haniaa2/SmartMugs/Notebooks/haniaa2/README.md

# ECE445 **Hani Al Majed** Notebook

# Week 2/6  
- Researched the power subsystem of commercially available products (the Ember Mug primarily).   
- 02/09/2023: Finalized Project Proposal.

# Week 2/13  
- Explored possible Qi Reciever Modules, ended up with the Adafruit universal Qi wireless charging [transmitter](https://www.adafruit.com/product/2162) and [receiver](https://www.adafruit.com/product/1901) modules to perform inductive charging of two Samsung 25R 18650 2500mAh 20A [Battery cells](https://www.18650batterystore.com/products/samsung-25r-18650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). These modules can be configured to track battery level and output a discharge cut-off voltage of 5V. 
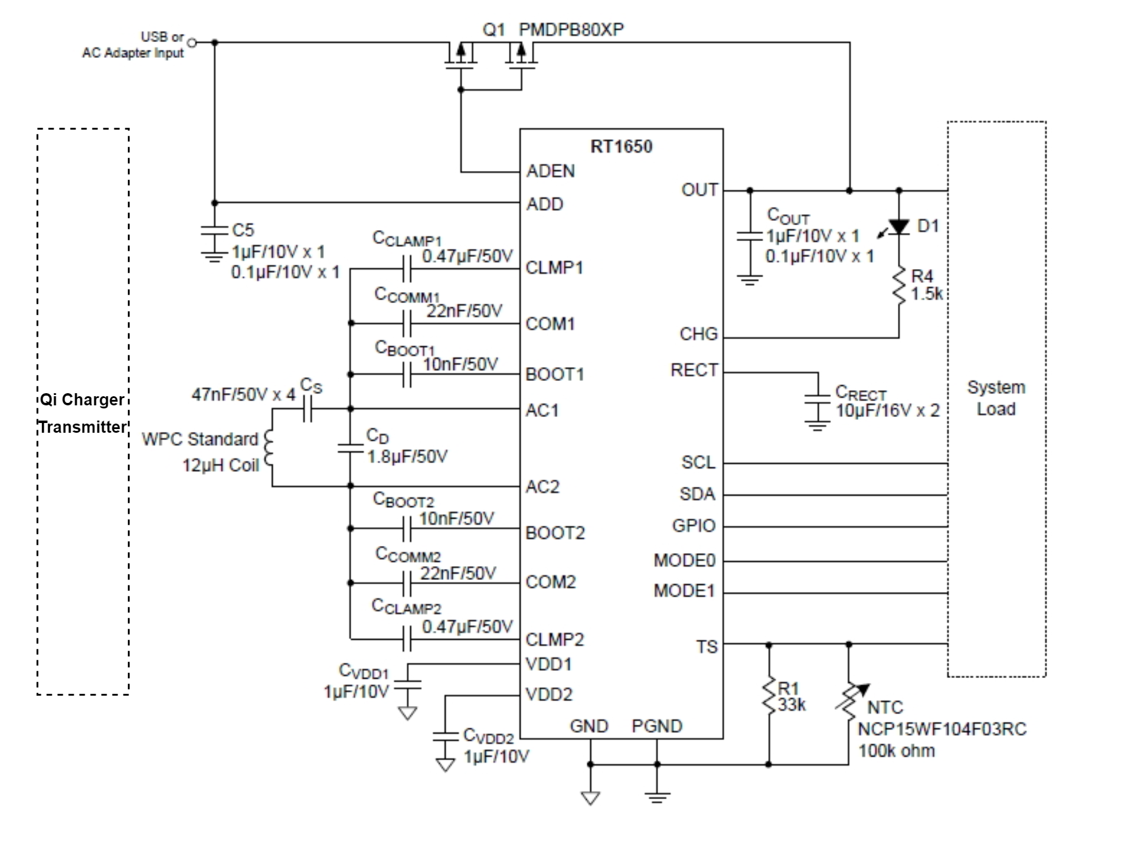
[picture p1: Notebooks/haniaa2/figures/RT1650-compliant-QiReciever-02-17-2023.png]
RT1650-compliant Qi Reciver


# Week 2/20  
- Finalized design document

# Week 2/27  
- 02/28/2023: Design Review with Prof. Mironenko was conducted.
- The block diagram was modified to take into account the comments of Prof. Mironenko 
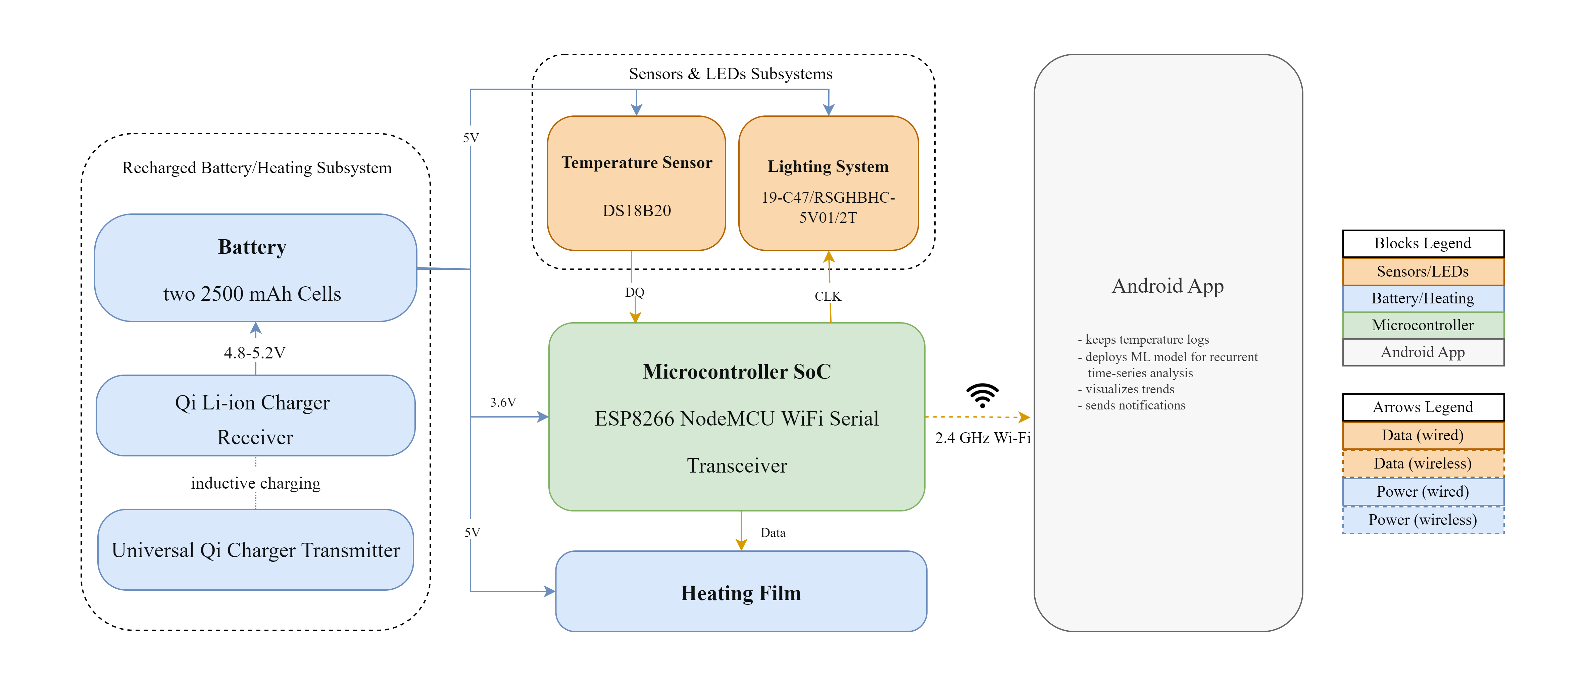
[picture p2: Notebooks/haniaa2/figures/block-diagram-03-02-2023.png]


# Week 3/6
- Actively developing the schematics of a NodeMCU Sheild to be connected to the PCB. Shelid footprint will be configured upon the successful completion of the PCB layout.   
- 03/08/2023: Selva & Jason proposed a single ESP32 SoC in lieu of the ESP8266 NodeMCU WiFi Serial Tranciever DevKit Board (rendering the previous design to be ineffective)
- 03/08/2023: Jason suggested the utilization of the TP4056-18650 Battery Management System as an intermediary layter between the Qi Reciever and the Li-ion Battey cells.  

# Week 3/20 
- Actively developing the schematics of the microcontroller subsystem with a [ESP32-WROVER-I](https://www.espressif.com/sites/default/files/documentation/esp32-wrover-e_esp32-wrover-ie_datasheet_en.pdf) MCU Module, [CP2102N-Axx-xQFN28](https://www.silabs.com/documents/public/data-sheets/cp2102n-datasheet.pdf) programmer, and mirco-usb port in a manner similar to the USB-to-UART serial conversion in the [ESSP32-C6 v4] (https://dl.espressif.com/dl/schematics/esp32_devkitc_v4-sch.pdf) Dvelopment kit. 
- The microcontroller expects 3.3-3.6V. To this end, I added the [AMS1117]([AMS1117](http://www.advanced-monolithic.com/pdf/ds1117.pdf)) LDO chip to regulate voltage to the desired voltage range.  
- Actively developing the power subsystem of our design to account for Jason's proposals. We have also added the TP4056-18650 battery management module to recharge the two battery cells and select the power supply output; the device is supplied with 5V form the USB bus if the USB port is connected. This addresses the contact bounce effects due to power spikes during external source power switching and reduces noise that causes battery exhaustion.
- The final power management subsystem will include a TP456-18650 Battey Mangement board connected to the Qi Reciever, the battery case, and an AMS1117 LDO voltage regulator.
- Siqi will handle the heating subsystem and would develop an automatic switching mechanism to adaptively control the temperature. 

# Week 3/27 
- The full device schametic is ready and a first PCB prototype is ready to be ordered.
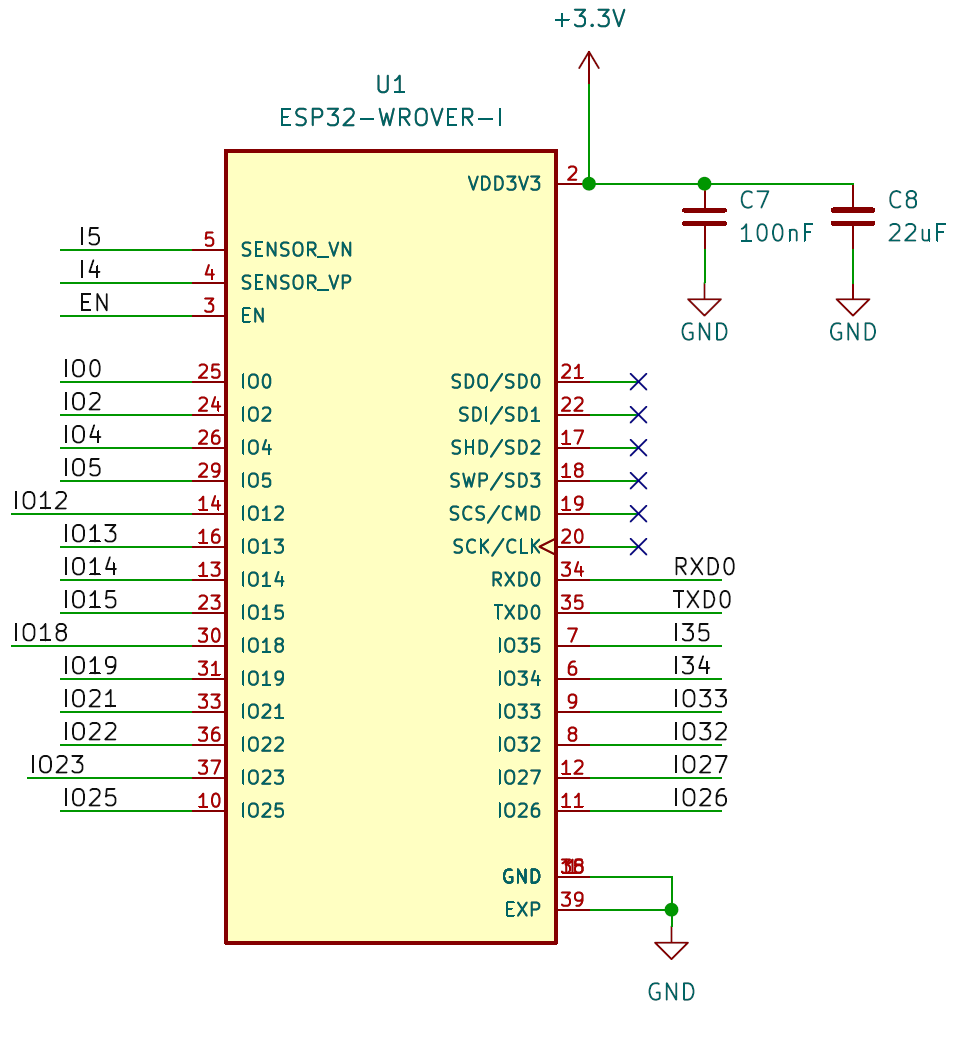
[picture p3: Notebooks/haniaa2/figures/mcu-module-03-25-2023.png]
MCU Module

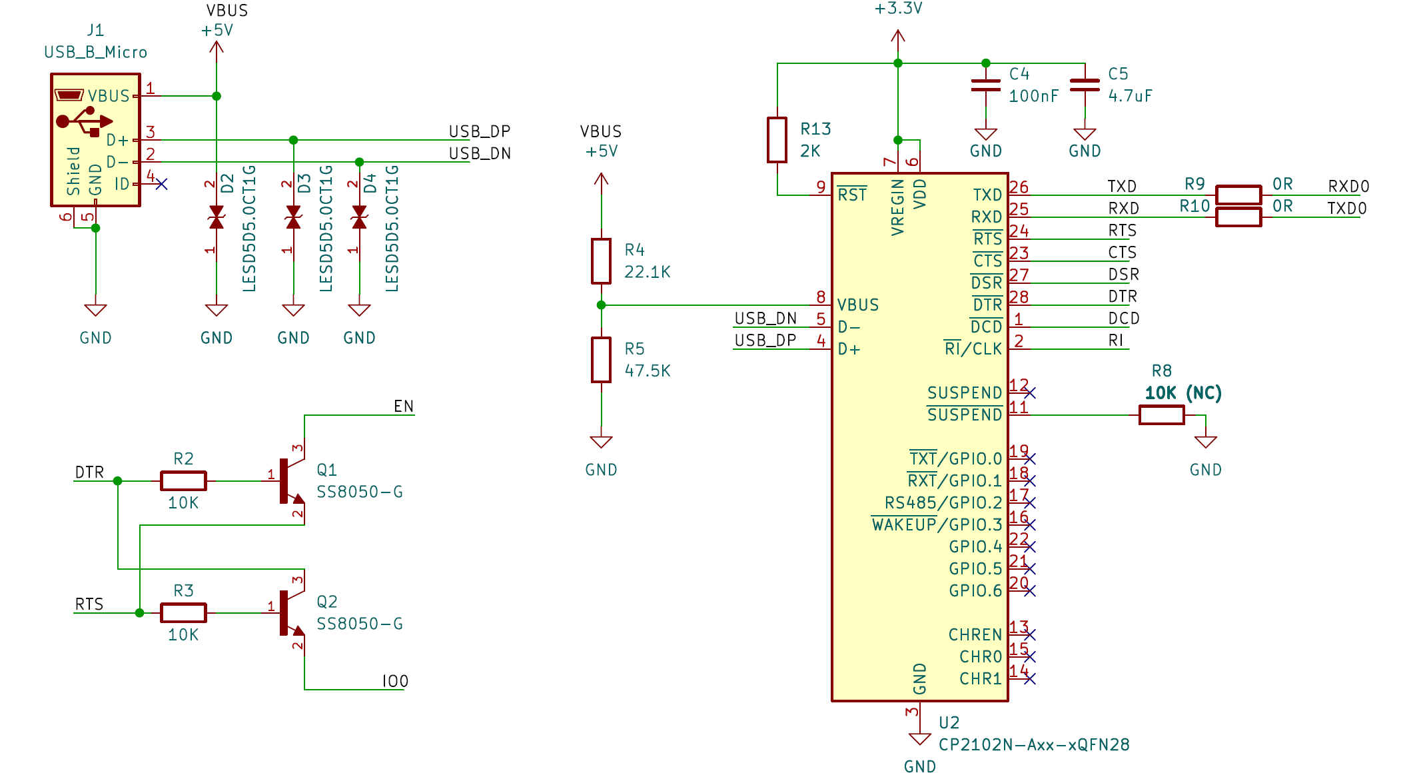
[picture p4: Notebooks/haniaa2/figures/mcu-programmer-03-25-2023.png]
MCU Programmer

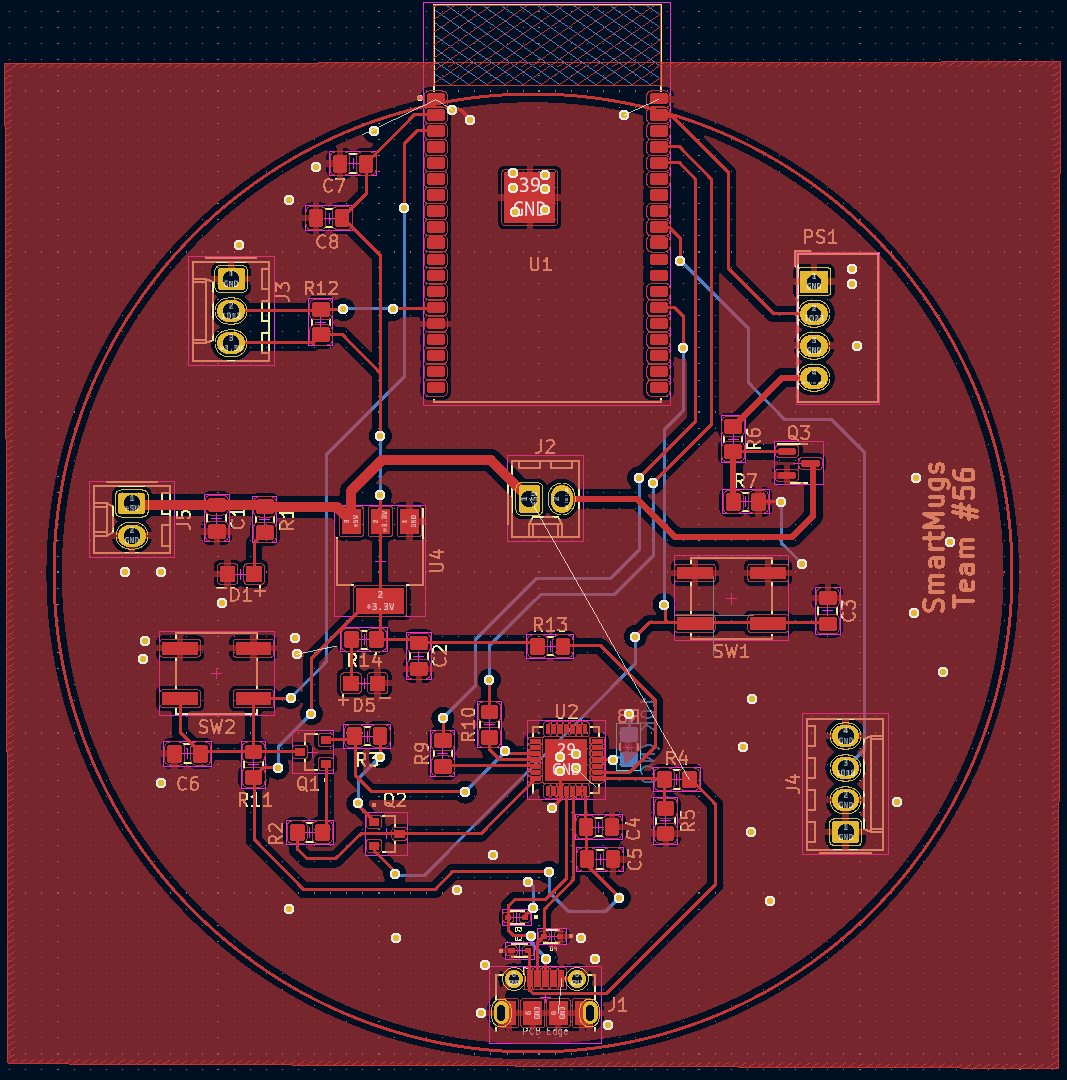
[picture p5: Notebooks/haniaa2/figures/pcb-v1-03-26-2023.png]
PCB Layout


# Week 4/3
- Siqi handled PCB soldering with me having supervisory role.  

# Week 4/10
- 04/19/2023: We had a meeting with Selva and chose to go with demoing on a breadboard instead since the PCB will take more time to solder and test. 

# Week 4/17
- 04/21/2023: Programmed the ESP32 DevKit to interface with my real-time database through a Google Firebase instance with a Wi-Fi client connection.
- 04/22/2023: The ESP32 was burnt due to connecting it with unprotected power circuitry.
- 04/23/2023: I got a spare ESP8266 in lieu of the ESP32 and decided to use that for our demo on Monday.
- I left Srishti with the MCU to integrate the Wi-Fi iterface with her frontend. 

# Week 4/24
- To balance out our work, I left Siqi and Srishti to do the full integration of the microcontroller unit with the circuit on the breadboard instead of having multiple MCUs. 
- Siqi will handle the heating element integration with a MOSFET that satisfies the specifications and requirements of our design. 

# Week 5/1
 - Collected further voltage traces of the Qi charger transmitter and the power management system to add them to the design verification section of the final report.
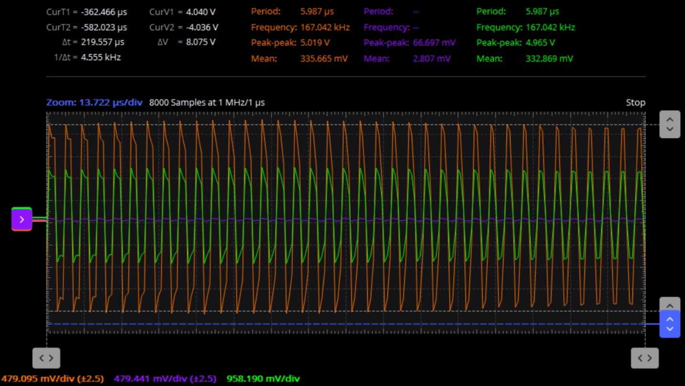
[picture p6: Notebooks/haniaa2/figures/qi_trans_vtrace-05-03-2023.jpg]

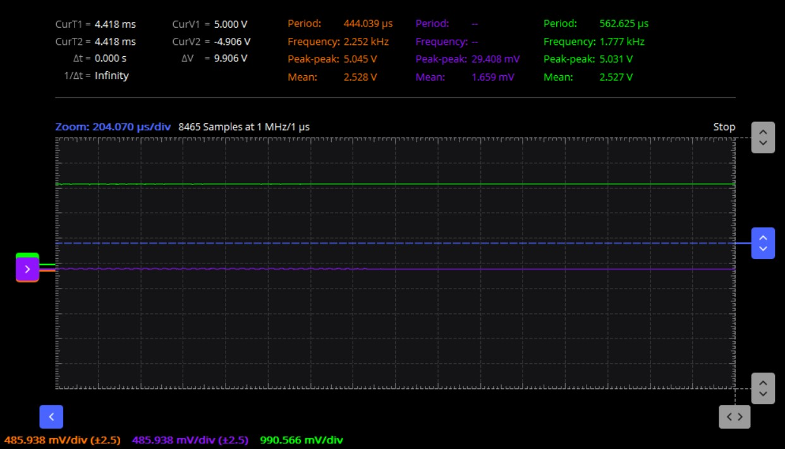
[picture p7: Notebooks/haniaa2/figures/power_management_vtrace-05-03-2023.jpg]


 - Working on the final report.
 - 05/01/2023: We had our final presentaion.
 - 05/03/2023: We had our final demo and submitted the final report!
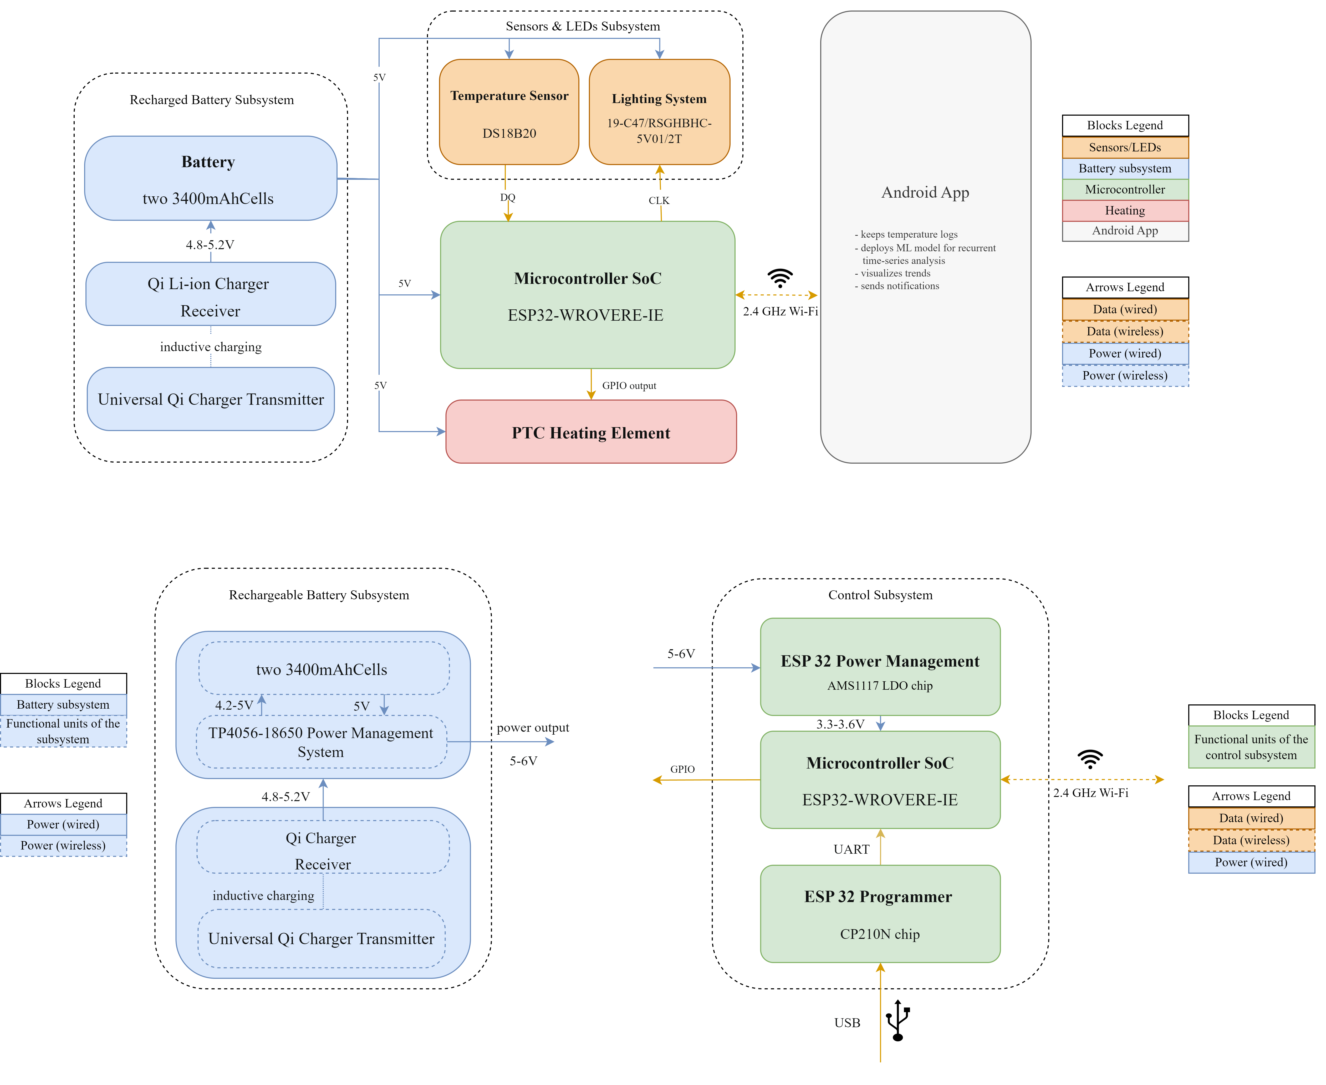
[picture p8: Notebooks/haniaa2/figures/final-block-diagram-05-03-2023.png]
Final Block Diagram
