haniaa2/SmartMugs/Notebooks/smogdil2/README.md

# ECE445 Srishti Modgil Notbook

# Week 02/06
- Project topics determined.
- Researching the design of smart mugs.
- Initial Project Proposal Finalized

# Week 02/13
-worked on design doc
- met with team members to discuss hwo to implement each subsystem
- research parts

# Week 02/20
-worked on design document 
- majority of research done this week 
- FInalaized a few part, such as heating element and microcontoller
- sumbitted finalazied design document 

# Week 03/06
- assigned roles to everyone 
- did some reaseach on how to build an app 
- deciced to build and IOS app 

# Week 03/13

- Created the app layout for the front page using uizard



# Week 03/20
- created the lay out for more of the pages of the app :





# Week 03/27
- finished the lay out for all the pages of the app :
 
 - submitted my individual progress report  

# Week 04/03
- created the ios app using swift

 
 
 - had meeting with my team and TA and decided to chnage the IOS app to a web app 

# Week 04/10

- created the whole front end of the web app :



# Week 04/17
- Building the circuit on the breadboard using the ESP32 Dev Board.
- 4/22: Demonstration the functionality of the circuit.  ESP32 Dev Board broke during our process of testing, we purchased the board immediately 
- 4/23: Connected the web app to ES8266. And connected ESP8266 to firebase real-time database 
- Test app with microcontoller, worked prefectly but not integreated with the heating system

# Week 04/24
- Mock presentation slides making and script writing.
- 4/29: Siqi and I met in the morning and finish most of the integration. Got the ESP32 and ingreated it with the web app and sensors and heating element 
- 4/30: Final prensentation preparation. Siqi and I took pictures and videos about what we go for the circuit so far. 
- FInished the slides for the presentation 

# Week 05/01
- 5/1: Final Presentation on May 1st, 8:30am. Presentation went very well
- 5/2: Whole breadboard circuit is completed  
- 5/3: Second Final Demo: Systems were integreated perfectly. Went very well.
