haniaa2/SmartMugs/Proposal.md

Team Members:
Srishti Modgil (smodgil2)
Siqi Lu (siqilu3)
Hani Al Majed (haniaa2)

# Problem

There is a problem with the inconvenience associated with maintaining the perfect temperature of beverages. Drinks can cool down quickly, making them no longer enjoyable. The need to reheat a drink can also be time consuming and inconvenient especially with a packed schedule. There is also a problem with waste. Disposable cups and reheating drinks can contribute to waste and negatively impact our environment. 
During our research, we found a smart mug called Embur Mug which can detect the temperature of the beverage and keeps it to a desired temperature. However, this mug is way too expensive for people to purchase with a price of 130 dollars. 

# Solution

We propose the creation of a smart mug. Our design will improve the Embur Mug functionally and financially. Our mug will be equipped with a temperature control system that will automatically regulate the temperature of its contents to keep the drink at a desirable level. The mug will also have an app interface  that will allow users to easily set up their preferred temperature, track their liquid intake and how fast they consume their liquid. The smart mug has the ability to keep drinks at the perfect drinking temperature and will eliminate the need for reheating. The smart mug will also track the amount of liquid in your cup at the moment. We will use a sensor to detect the weight of the liquid and display the number of ounces on your app. The smart mug not only improves the hot beverage drinking experience but also helps promote sustainable habits. 

# Solution Components

## Subsystem 1 Temperature Sensor 
- Will be integrating the industry standard temperature sensor by Maxim Integrated https://www.digikey.com/en/products/detail/analog-devices-inc.-maxim-integrated/DS18B20%2BT%26R/3478852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 
- Senses the temperature of the liquid 

## Subsystem 2 Microcontroller with Wifi transceiver 
- ESP8266 SoC board: standard Arduino generic microcontroller with a serial Wifi transceiver to regulate power, control the other subsystems, and send logs to a server that visualizes/analyzes data and handles app notifications.  
https://www.amazon.com/DIYmall-ESP8266-ESP-01S-Serial-Transceiver/dp/B00O34AGSU 

## Subsystem 3 Warning System
- LED indicating the temperature scale of the beverage (on the mug)
- Send notification to phones if too hot or too cold. (user setting on the apps)

## Subsystems 4 Weight scale system 
- Displays the number of ounces of liquid in the mug 
- Give notification of refiling via LEDs on the mug

## Subsystems 5 Heating System
- Maintaining the beverage to a desired temperature/healthy temperature. 

# Criterion for Success

- Detecting the temperature of the beverage and showing it on the mug via LEDs.
- Tracking drinking habits and visualizing the data on the apps
- Tracking the amount of liquid in the mug and giving refilling notifications via LEDs on the mug.

# Resources
- Ember Mug: https://ember.com/products/ember-mug-2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
