haniaa2/SmartMugs/Circuit/BAT760-7/BAT760-7.step

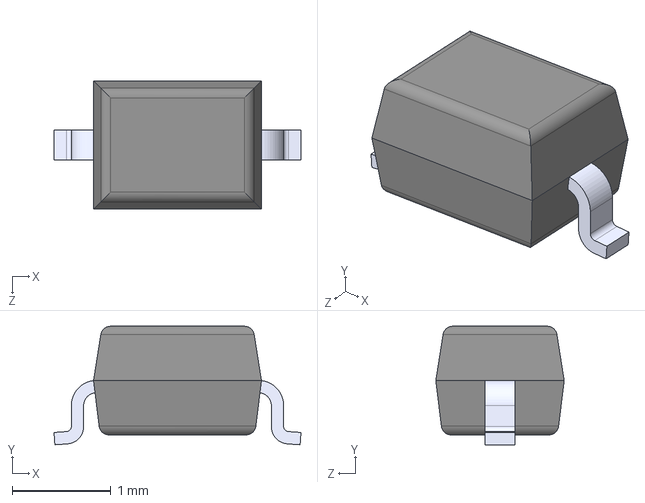
[picture p13: CAD file, 2023-03-29]
Circuit/BAT760-7/BAT760-7.step
2.50 x 1.20 x 1.30 mm
