haniaa2/SmartMugs/Circuit/ESP32-WROVER-I/ESP32-WROVER-I.step

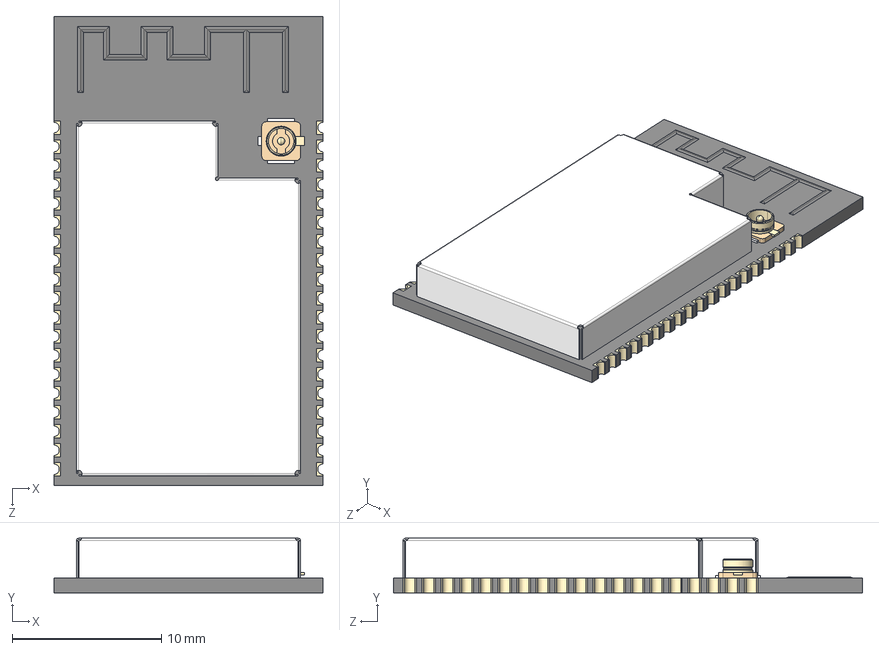
[picture p14: CAD file, 2023-03-29]
Circuit/ESP32-WROVER-I/ESP32-WROVER-I.step
18.0 x 3.65 x 31.4 mm
