haniaa2/SmartMugs/Circuit/LESD5D5.0CT1G/LESD5D5.0CT1G.step

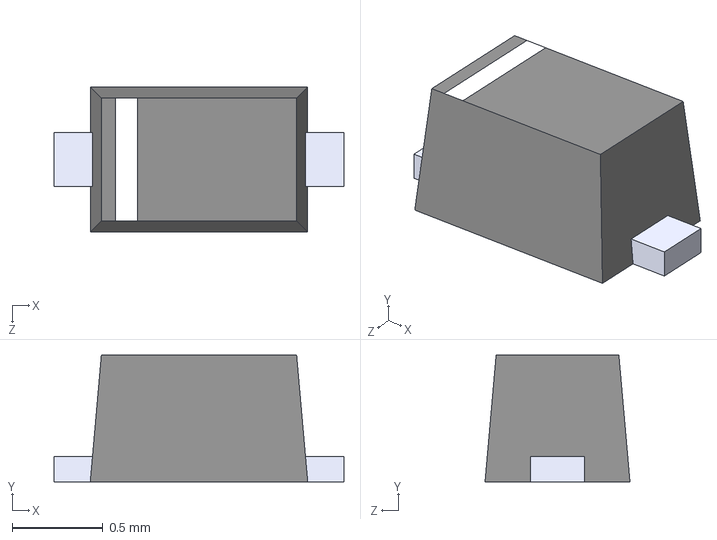
[picture p15: CAD file, 2023-03-29]
Circuit/LESD5D5.0CT1G/LESD5D5.0CT1G.step
1.60 x 0.7 x 0.8 mm
