haniaa2/SmartMugs/Circuit/LTST-C171KRKT/LTST-C171KRKT.step

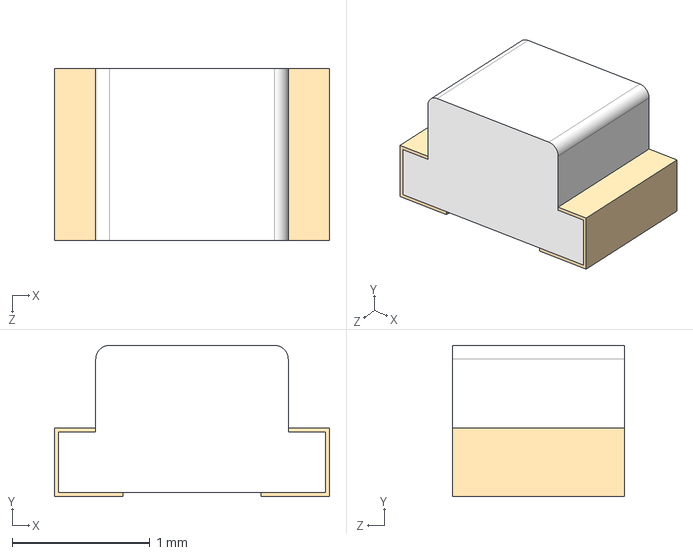
[picture p16: CAD file, 2023-04-12]
Circuit/LTST-C171KRKT/LTST-C171KRKT.step
2.00 x 1.10 x 1.25 mm
