haniaa2/SmartMugs/Circuit/SS8050-G/SS8050-G.step

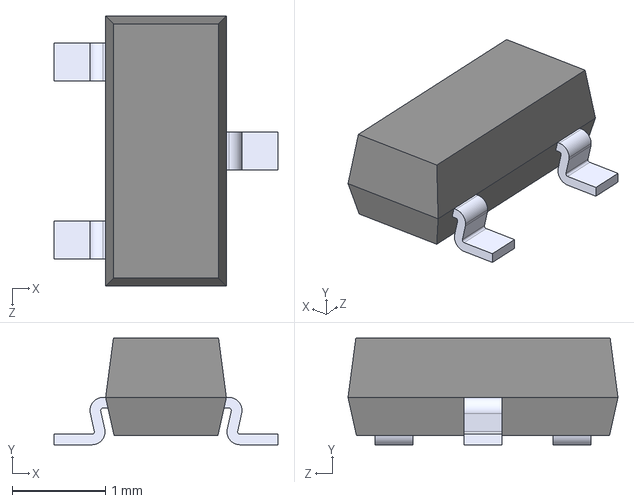
[picture p17: CAD file, 2023-03-29]
Circuit/SS8050-G/SS8050-G.step
2.40 x 1.14 x 2.90 mm
