haniaa2/SmartMugs/Notebooks/siqilu3/heating_test/heating_test.asc

Heater: res; 25
M1: nmos; Si7336ADP
R1: res; 10k
R2: res; 120
V2: voltage; 5
Vesp32: voltage; 0
Named nets: 0, Vd
.tran 0 100ms 0
