haniaa2/SmartMugs/Notebooks/siqilu3/heating_system/heating.kicad_pcb

## KiCad design Notebooks/siqilu3/heating_system/heating.kicad_pcb (2023-03-29)

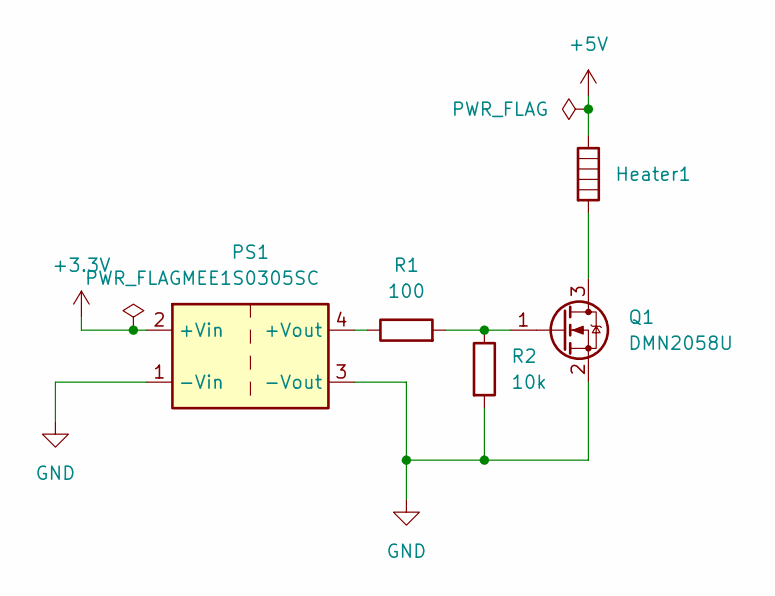
[picture p18: schematic heating.kicad_sch]

Parts:
Heater1: Heater; R_0805_2012Metric_Pad1.20x1.40mm_HandSolder
PS1: MEE1S0305SC; Converter_DCDC_Murata_MEE1SxxxxSC_THT
Q1: DMN2058U; SOT-23
R1: 100; R_0805_2012Metric_Pad1.20x1.40mm_HandSolder
R2: 10k; R_0805_2012Metric_Pad1.20x1.40mm_HandSolder

Connections:
+3.3V: PS1.2 (+Vin)
+5V: Heater1.1
GND: PS1.1 (-Vin), PS1.3 (-Vout), Q1.2 (S), R2.2
unnamed: Heater1.2, Q1.3 (D)
unnamed: PS1.4 (+Vout), R1.1
unnamed: Q1.1 (G), R1.2, R2.1

Board: 2 copper layers, 5 parts (0 on the bottom side), 4 nets, no tracks yet.
