haniaa2/SmartMugs/Circuit/Circuit.kicad_pcb

## KiCad design Circuit/Circuit.kicad_pcb (2023-04-12)

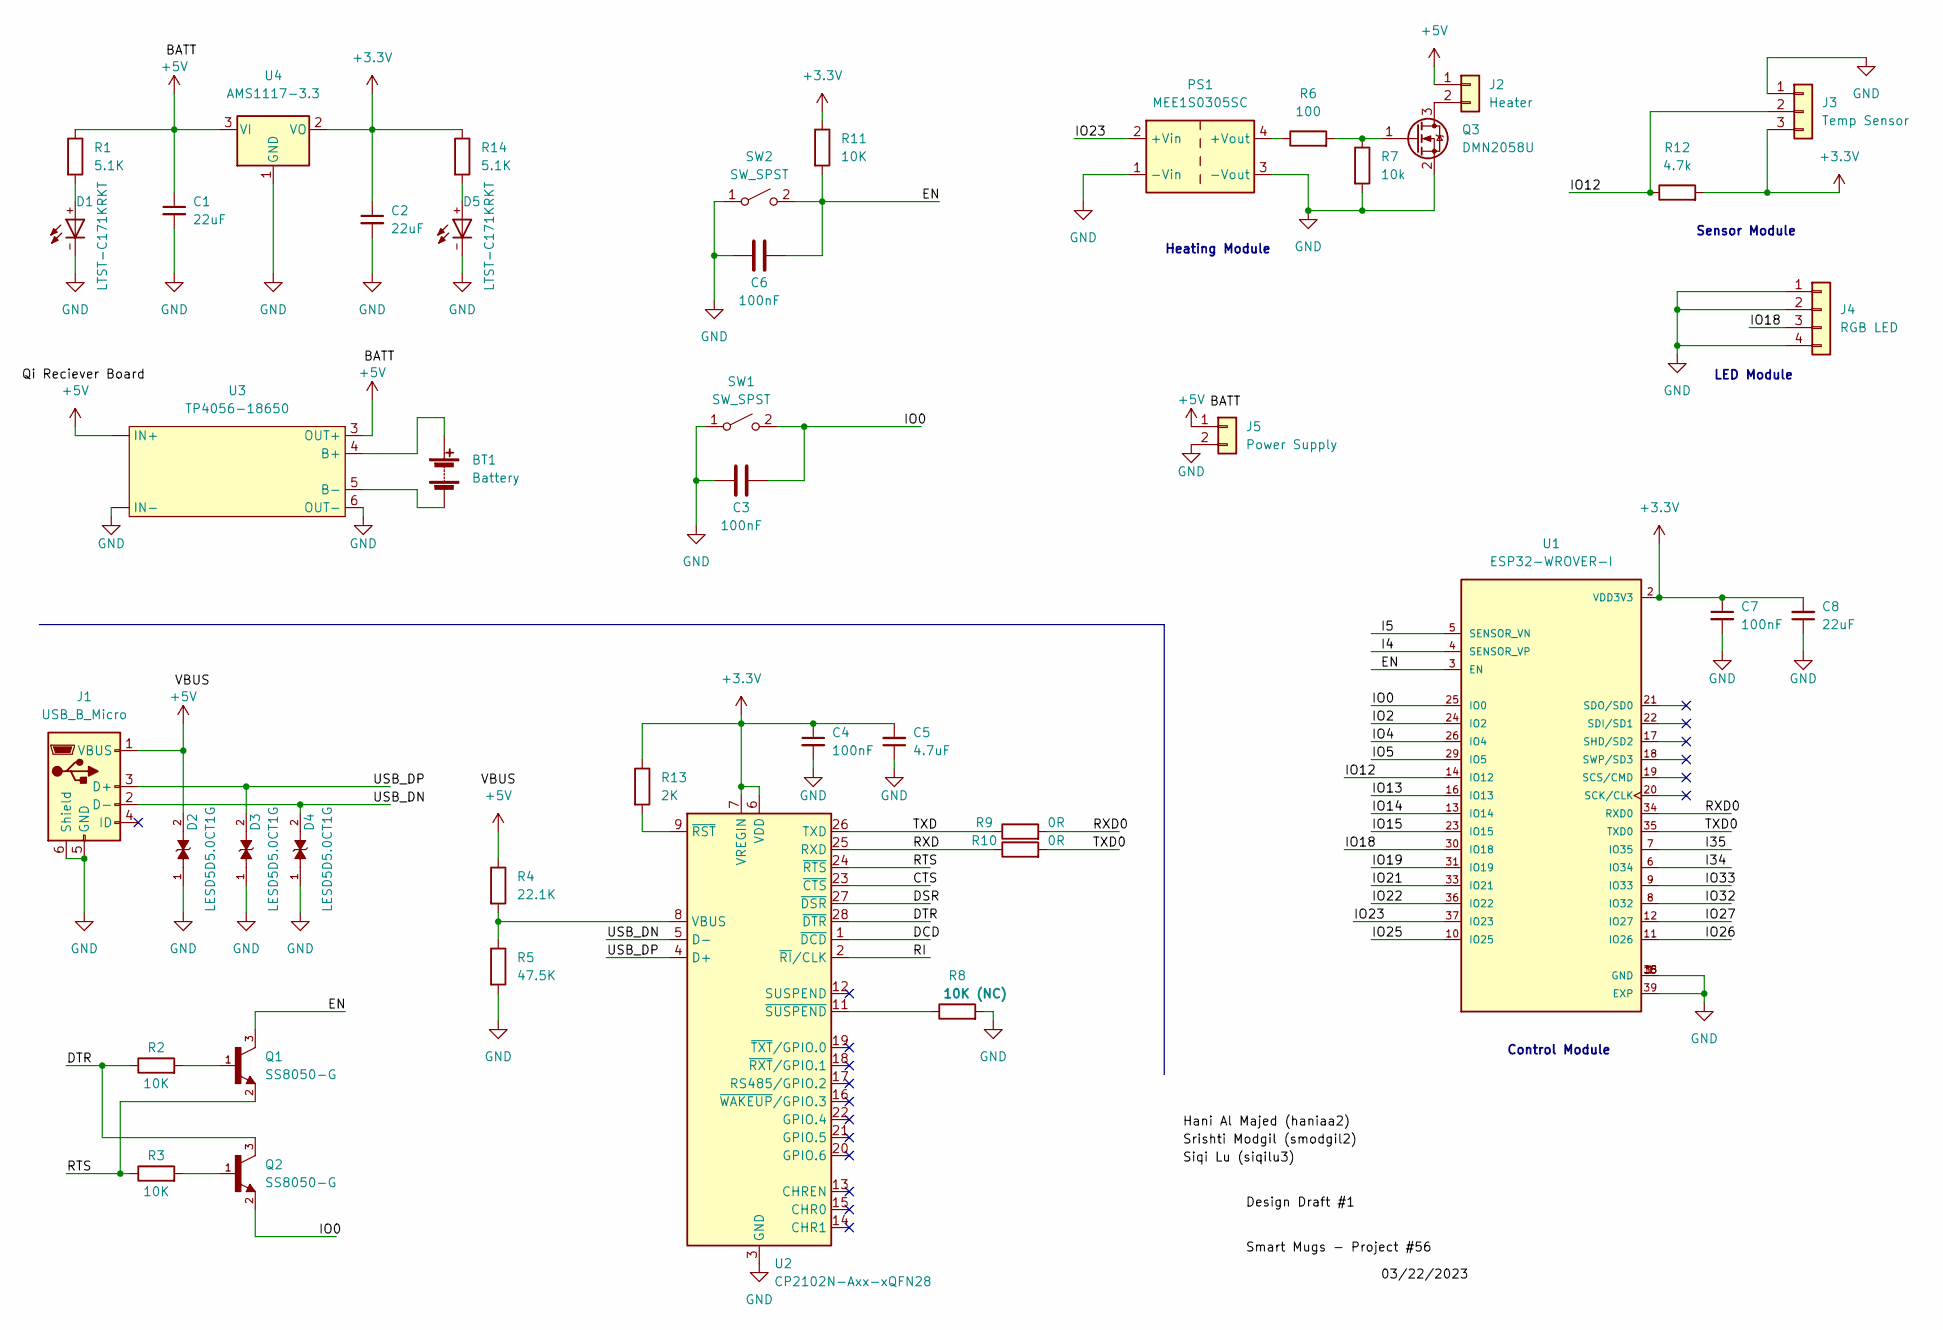
[picture p19: schematic Circuit.kicad_sch]

Parts:
BT1: Battery
C1, C2, C8: 22uF; C_0805_2012Metric_Pad1.18x1.45mm_HandSolder
C3, C4, C6, C7: 100nF; C_0805_2012Metric_Pad1.18x1.45mm_HandSolder
C5: 4.7uF; C_0805_2012Metric_Pad1.18x1.45mm_HandSolder
D1, D5: LTST-C171KRKT; DIOC200X125X110
D2, D3, D4: LESD5D5.0CT1G; TVS_LESD5D5.0CT1G; PARTREV O
J1: USB_B_Micro; USB_Micro-B_Molex-105017-0001
J2: Heater; Molex_KK-254_AE-6410-02A_1x02_P2.54mm_Vertical
J3: Temp Sensor; Molex_KK-254_AE-6410-03A_1x03_P2.54mm_Vertical
J4: RGB LED; Molex_KK-254_AE-6410-04A_1x04_P2.54mm_Vertical
J5: Power Supply; Molex_KK-254_AE-6410-02A_1x02_P2.54mm_Vertical
PS1: MEE1S0305SC; Converter_DCDC_Murata_MEE1SxxxxSC_THT
Q1, Q2: SS8050-G; TRANS_SS8050-G; PARTREV A
Q3: DMN2058U; SOT-23
R1, R14: 5.1K; R_0805_2012Metric_Pad1.20x1.40mm_HandSolder
R2, R3, R11: 10K; R_0805_2012Metric_Pad1.20x1.40mm_HandSolder
R4: 22.1K; R_0805_2012Metric_Pad1.20x1.40mm_HandSolder
R5: 47.5K; R_0805_2012Metric_Pad1.20x1.40mm_HandSolder
R6: 100; R_0805_2012Metric_Pad1.20x1.40mm_HandSolder
R7: 10k; R_0805_2012Metric_Pad1.20x1.40mm_HandSolder
R8: 10K (NC); R_0805_2012Metric_Pad1.20x1.40mm_HandSolder
R9, R10: 0R; R_0805_2012Metric_Pad1.20x1.40mm_HandSolder
R12: 4.7k; R_0805_2012Metric_Pad1.20x1.40mm_HandSolder
R13: 2K; R_0805_2012Metric_Pad1.20x1.40mm_HandSolder
SW1, SW2: SW_SPST; SW_Push_1P1T_NO_CK_KSC6xxJ
U1: ESP32-WROVER-I; XCVR_ESP32-WROVER-I; DIGI-KEY_PART_NUMBER 1904-1008-1-ND
U2: CP2102N-Axx-xQFN28; QFN-28-1EP_5x5mm_P0.5mm_EP3.35x3.35mm
U3: TP4056-18650
U4: AMS1117-3.3; SOT-223-3_TabPin2

Connections:
+3.3V: C2.1, C4.1, C5.2, C7.1, C8.2, J3.3, R11.1, R12.2, R13.1, R14.1, U1.2 (VDD3V3), U2.6 (VDD), U2.7 (VREGIN), U4.2 (VO)
+5V: C1.1, D2.2, J1.1 (VBUS), J2.1, J5.1, R1.1, R4.1, U3. (IN+), U3.3 (OUT+), U4.3 (VI)
/CTS: U2.23 (~CTS)
/DCD: U2.1 (~DCD)
/DSR: U2.27 (~DSR)
/DTR: Q2.3, R2.1, U2.28 (~DTR)
/EN: C6.2, Q1.3, R11.2, SW2.2 (B), U1.3 (EN)
/I4: U1.4 (SENSOR_VP)
/I5: U1.5 (SENSOR_VN)
/I34: U1.6 (IO34)
/I35: U1.7 (IO35)
/IO0: C3.2, Q2.2, SW1.2 (B), U1.25 (IO0)
/IO2: U1.24 (IO2)
/IO4: U1.26 (IO4)
/IO5: U1.29 (IO5)
/IO12: J3.2, R12.1, U1.14 (IO12)
/IO13: U1.16 (IO13)
/IO14: U1.13 (IO14)
/IO15: U1.23 (IO15)
/IO18: J4.3, U1.30 (IO18)
/IO19: U1.31 (IO19)
/IO21: U1.33 (IO21)
/IO22: U1.36 (IO22)
/IO23: PS1.2 (+Vin), U1.37 (IO23)
/IO25: U1.10 (IO25)
/IO26: U1.11 (IO26)
/IO27: U1.12 (IO27)
/IO32: U1.8 (IO32)
/IO33: U1.9 (IO33)
/RI: U2.2 (~RI/CLK)
/RTS: Q1.2, R3.1, U2.24 (~RTS)
/RXD: R10.1, U2.25 (RXD)
/RXD0: R9.2, U1.34 (RXD0)
/TXD: R9.1, U2.26 (TXD)
/TXD0: R10.2, U1.35 (TXD0)
/USB_DN: D4.2, J1.2 (D-), U2.5 (D-)
/USB_DP: D3.2, J1.3 (D+), U2.4 (D+)
GND: C1.2, C2.2, C3.1, C4.2, C5.1, C6.1, C7.2, C8.1, D1.-, D2.1, D3.1, D4.1, D5.-, J1.5 (GND), J1.6 (Shield), J3.1, J4.1, J4.2, J4.4, J5.2, PS1.1 (-Vin), PS1.3 (-Vout), Q3.2 (S), R5.2, R7.2, R8.2, SW1.1 (A), SW2.1 (A), U1.1 (GND), U1.15 (GND), U1.38 (GND), U1.39 (EXP), U2.3 (GND), U2.29 (GND), U3. (IN+), U3.6 (OUT-), U4.1 (GND)
unnamed: BT1.1 (+), U3.4 (B+)
unnamed: BT1.2 (-), U3.5 (B-)
unnamed: D5.+, R14.2
unnamed: J2.2, Q3.3 (D)
unnamed: PS1.4 (+Vout), R6.1
unnamed: Q1.1, R2.2
unnamed: Q2.1, R3.2
unnamed: Q3.1 (G), R6.2, R7.1
unnamed: D1.+, R1.2
unnamed: R4.2, R5.1, U2.8 (VBUS)
unnamed: R8.1, U2.11 (~SUSPEND)
unnamed: R13.2, U2.9 (~RST)

Notes on the sheet:
Control Module
Sensor Module
Heating Module
LED Module

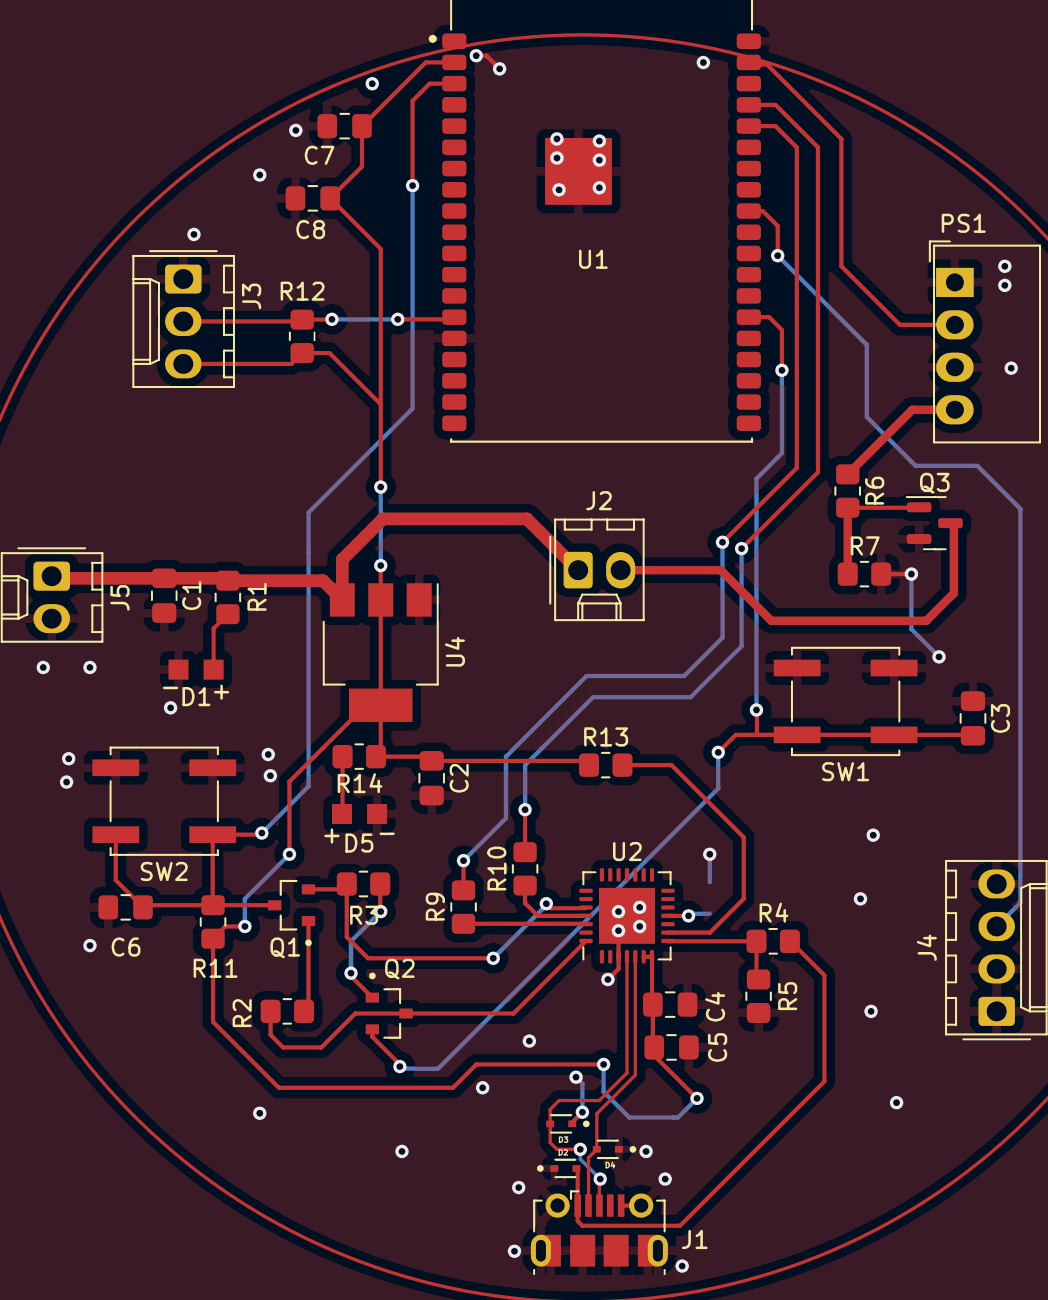
[picture p20: board Circuit.kicad_pcb from above]

Board: 2 copper layers, 41 parts (1 on the bottom side), 26 nets.
