haniaa2/SmartMugs/(commit log)

2023-03-08 add sch
    [Circuit.kicad_pcb, Circuit.kicad_sch]
2023-03-27 PUA0305S1A
    DC/DC CONVERTER 5V 1W
2023-03-29 Update Circuit.sch file
    [BAT760-7.step, Circuit.kicad_sch, ESP32-WROVER-I.step, LESD5D5.0CT1G.step, SS8050-G.step]
2023-04-01 updated sch
    [Circuit.kicad_sch]
2023-04-02 Update PCB
    [Circuit.kicad_pcb, Circuit.kicad_sch]
2023-04-12 update log
    [Circuit.kicad_pcb, LTST-C171KRKT.step]
2023-04-18 Add files via upload
    add heating part design
    [heating.csv, heating.kicad_pcb, heating.kicad_sch, smartmug.kicad_pcb]
2023-04-23 Add files via upload
    testing log of the heating subsystem
2023-04-24 Add files via upload
    heating and sensing
2023-04-29 Updated Heating and Sensor Subsystem code
2023-04-29 esp32
    hi
2023-04-29 Create esp32-test
2023-04-29 Create esp32_test2
2023-04-29 Almost completed
    heating element circuit yet to be done; wifi controlled circuit on and off of the LED works using esp32; temperature should be detected correctly but not verified yet; the LED indicate if the heater is on/off;
    [smartmug.ino]
2023-05-02 add test files for heating system
2023-05-02 esp32 tutorial
